gthomas/WorldsVeryFirst/juris/c-75/specimen.jpg

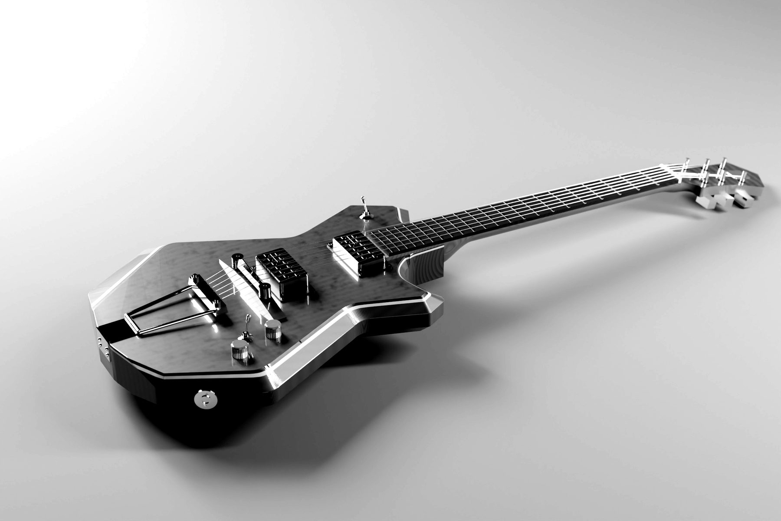
juris/c-75/specimen.jpg
