gthomas/WorldsVeryFirst/juris/c-75a/specimen.jpg

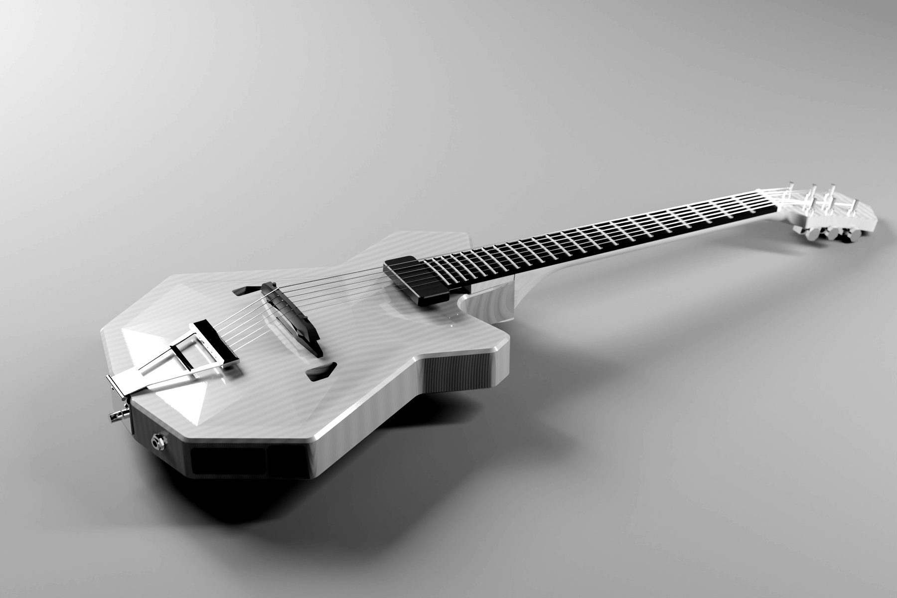
juris/c-75a/specimen.jpg
