gthomas/WorldsVeryFirst/juris-c75/files/juris_headstock_production.pdf

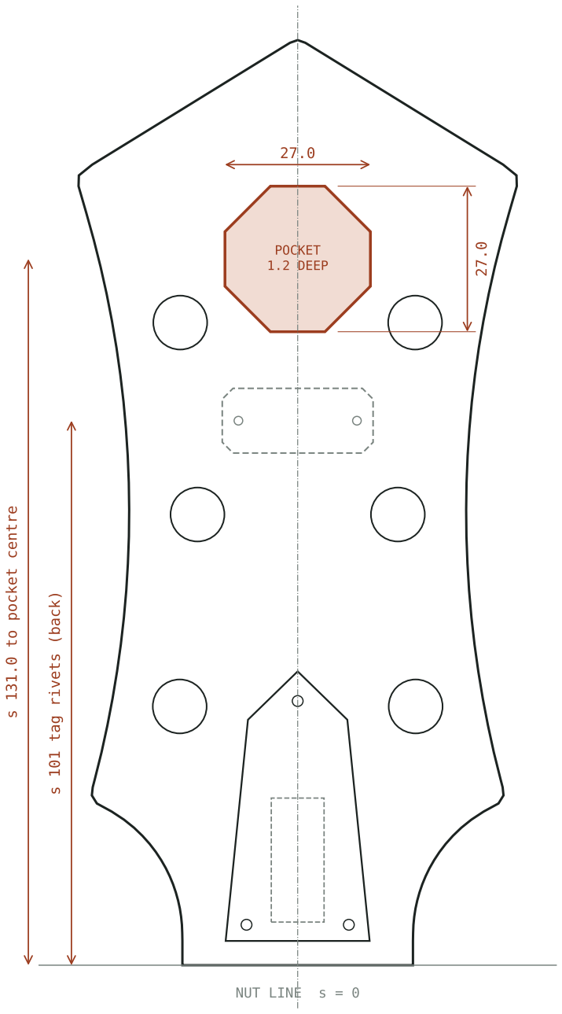
[picture p3: figure]
s 131.0 to pocket centre; s 101 tag rivets (back); NUT LINE; POCKET; DEEP

# JURIS PROFESSIONAL INSTRUMENTS

PRODUCTION HEADSTOCK | · | INSIGNIA POCKET | · | C-75 / C-75A / C-75T
1 | INSIGNIA POCKET: octagon 27.0 x 27.0, flats 10.13, centred on the centreline at s = 131.0.
| Depth 1.2 from the finished face (= plate thickness; plate sits flush). Flat floor.
| Corners are 135 deg: cut with a 1/16 in (1.6) end mill or smaller, or radius the plate corners to suit.
| Cut after the face veneer is glued and levelled; check depth against the actual plate before finishing.
2 | INSIGNIA PLATE (supplied): 1.2 nickel silver, etched, gutters filled black. Glue in after finish (epoxy).
3 | TRUSS ROD COVER: rosewood, JURIS engraved 0.3 deep and filled black, three screws, over the access slot.
4 | ASSET TAG (back of headstock): 28 x 12 plate, surface mounted after finish.
| Two rivet holes at x = +/-11, s = 101 (shown through), sized to the rivets supplied.
5 | CLEARANCE: pocket edge to the top tuner holes is 5.7 ; leaves about 3 mm to a 15 mm bushing washer.

Outline, tuner holes, slot and cover unchanged from Juris.dxf.

Not to scale as printed: work from juris_headstock_production.dxf. Solid: face. Dashed: truss slot under the cover.
Dotted: asset tag on the back, shown through.
