gthomas/WorldsVeryFirst/colonelhead.950aa0d0.jpg

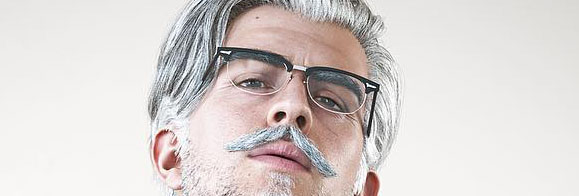
colonelhead.950aa0d0.jpg
