gthomas/WorldsVeryFirst/HARLAND.8d7c5698.gif

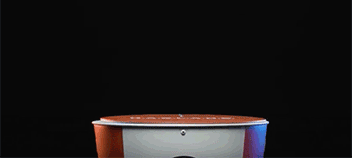
HARLAND.8d7c5698.gif
