gthomas/WorldsVeryFirst/juris-c75/prototype.jpg

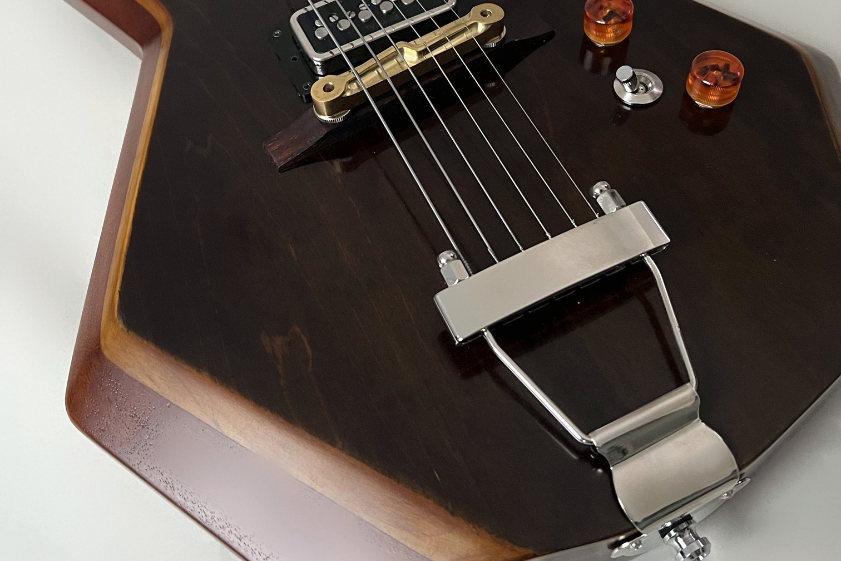
juris-c75/prototype.jpg
