gthomas/WorldsVeryFirst/juris/plan_juris-c75.png

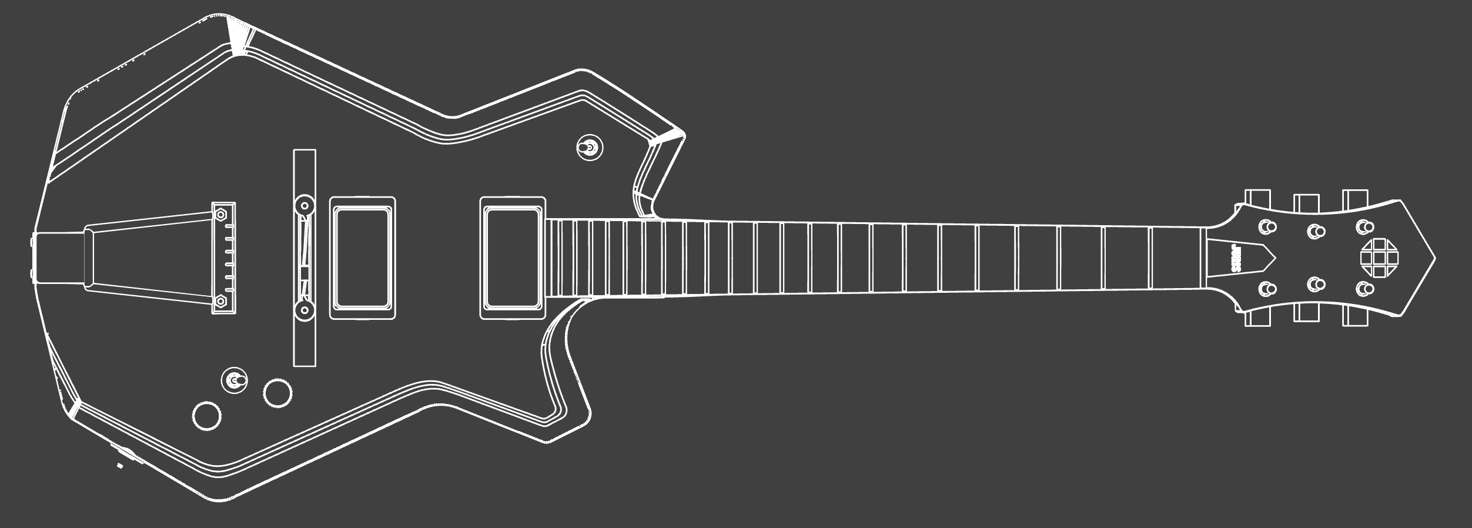
juris/plan_juris-c75.png
