gthomas/WorldsVeryFirst/juris/plan_juris-c75a.png

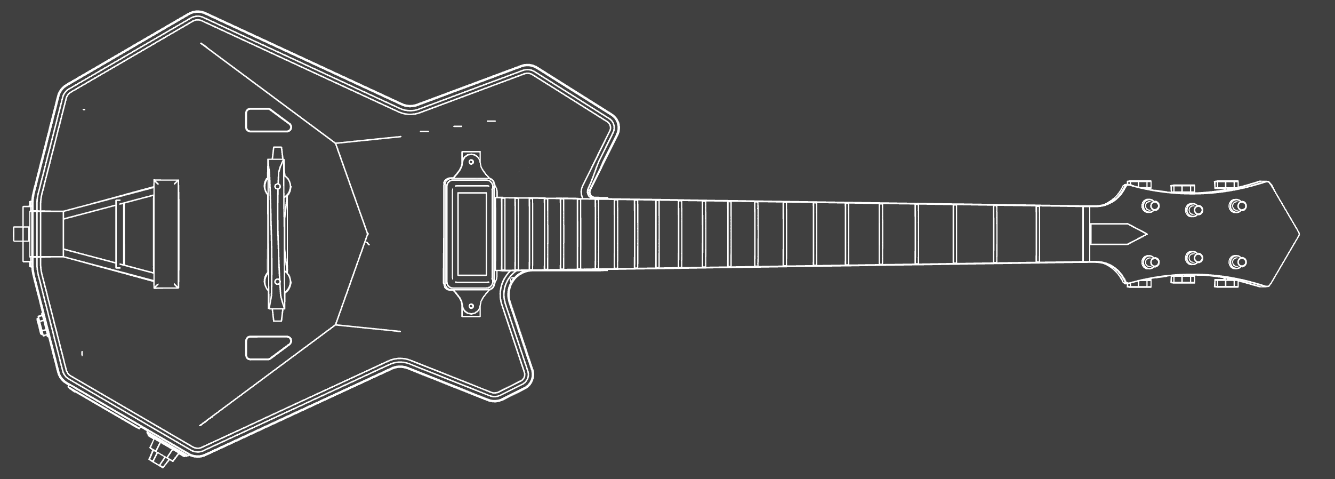
juris/plan_juris-c75a.png
