gthomas/WorldsVeryFirst/juris/plan_juris-c75t.png

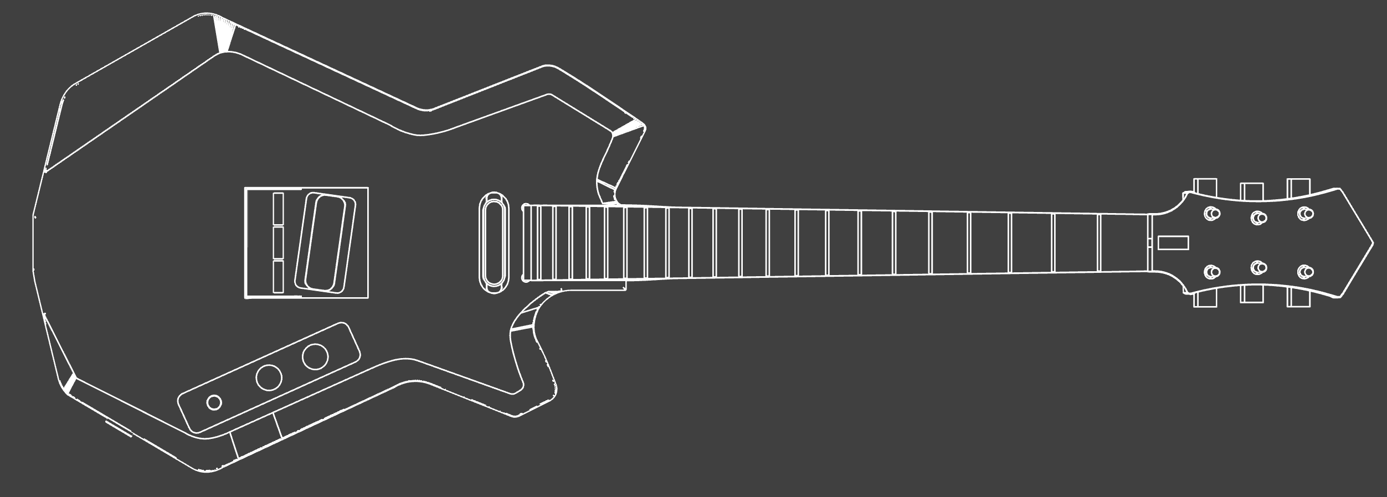
juris/plan_juris-c75t.png
