gthomas/WorldsVeryFirst/juris/share-c75.png

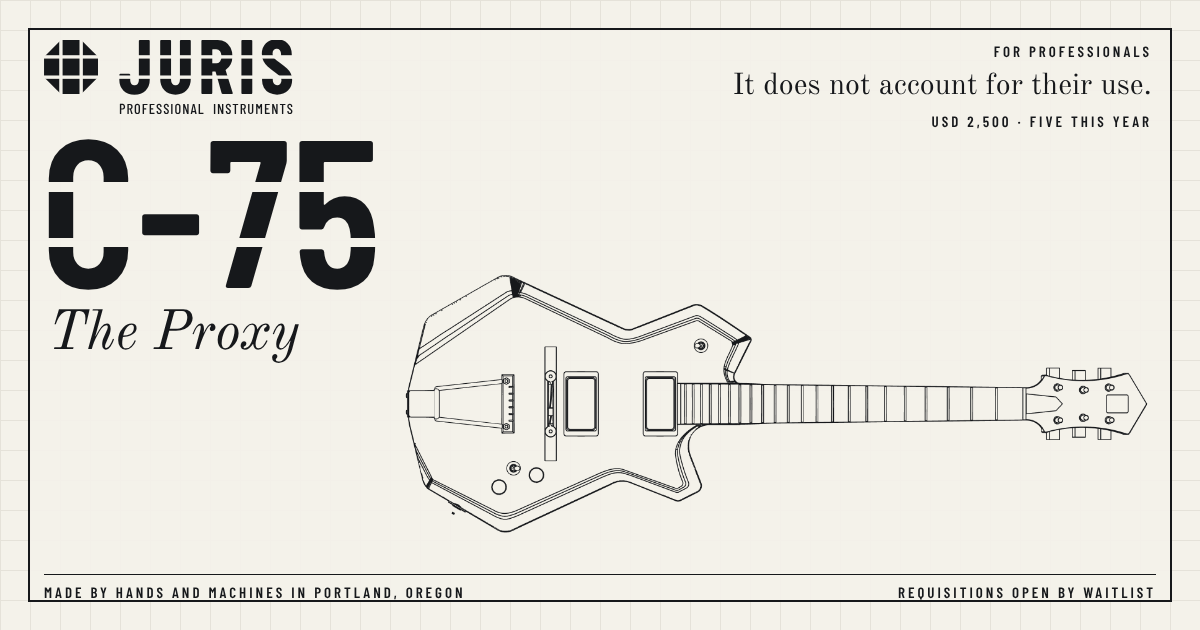
juris/share-c75.png
