gthomas/WorldsVeryFirst/lostinreddit.d3262f15.jpg

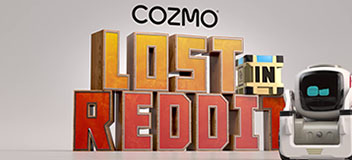
lostinreddit.d3262f15.jpg
