gthomas/WorldsVeryFirst/peeworldtrump.63bd835a.gif

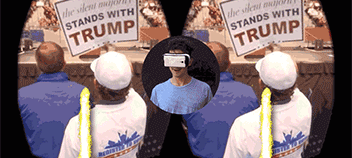
peeworldtrump.63bd835a.gif
