gthomas/WorldsVeryFirst/saturn.009b1ad3.jpg

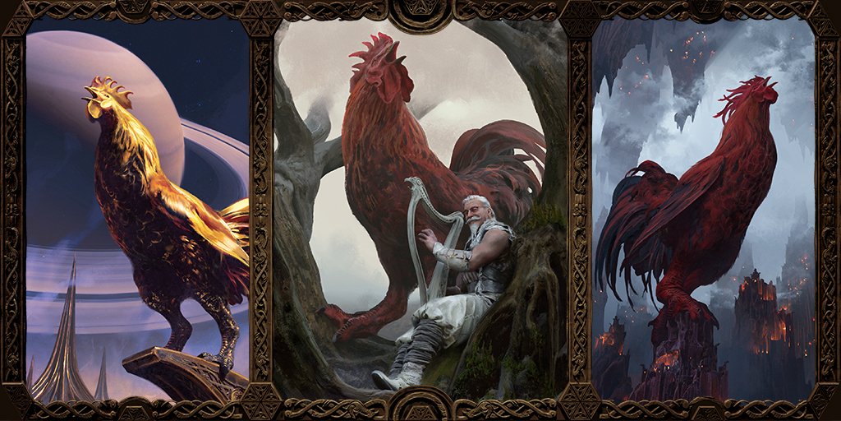
saturn.009b1ad3.jpg
