gthomas/WorldsVeryFirst/soy_route.58384286.png

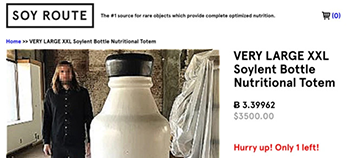
soy_route.58384286.png
