gthomas/WorldsVeryFirst/verizon_minecraft_videocall.c32c5149.gif

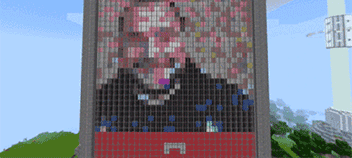
verizon_minecraft_videocall.c32c5149.gif
