gthomas/WorldsVeryFirst/juris-c75/files/headstock/truss_rod_cover.step

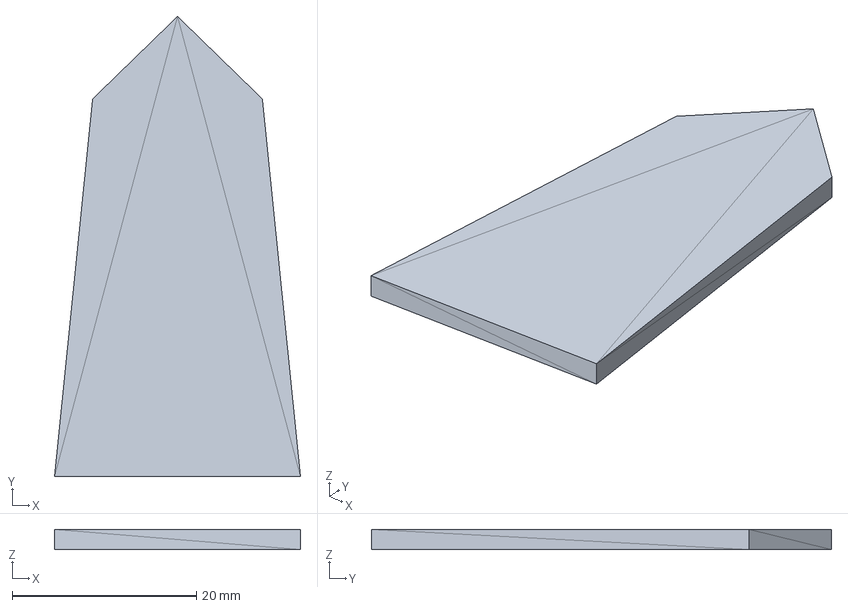
[picture p16: CAD file, 2026-11-13]
juris-c75/files/headstock/truss_rod_cover.step
26.7 x 50.0 x 2.20 mm
