gthomas/WorldsVeryFirst/juris-c75a/files/neck.stl

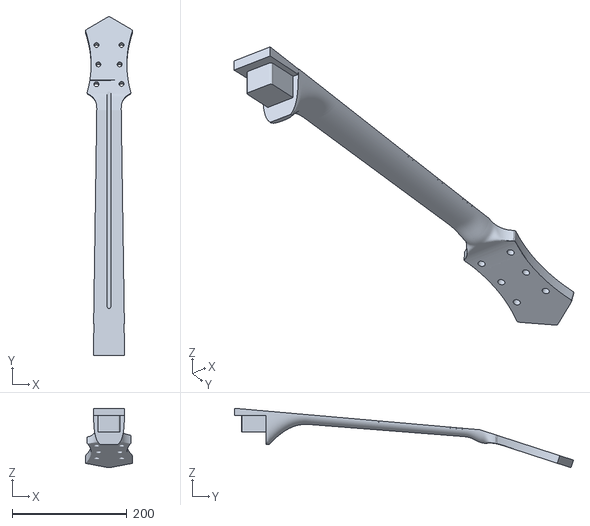
[picture p18: CAD file, 2026-11-13]
juris-c75a/files/neck.stl
81.4 x 591.9 x 103.8
