gthomas/WorldsVeryFirst/juris-c75t/files/body.stl

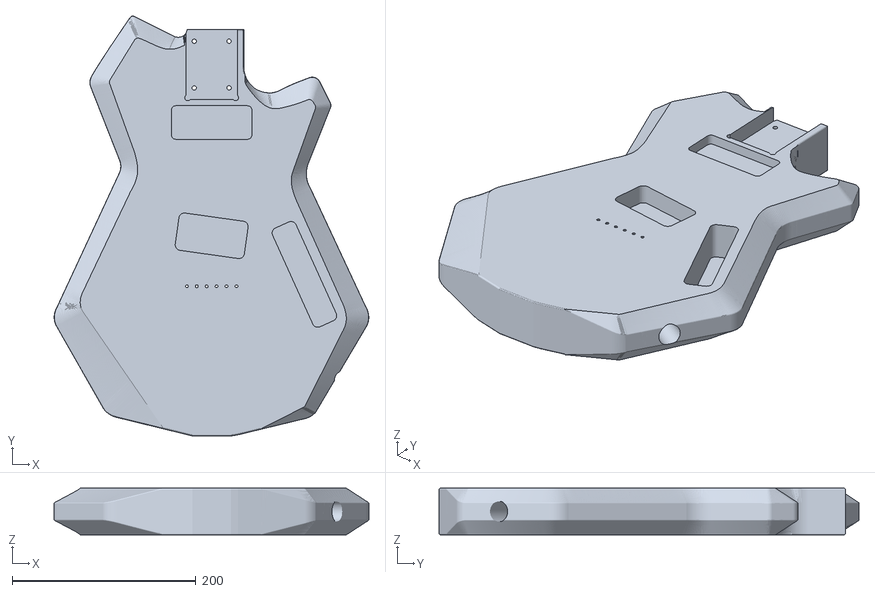
[picture p19: CAD file, 2026-11-13]
juris-c75t/files/body.stl
342.6 x 457.3 x 50.8
