gthomas/WorldsVeryFirst/juris-c75/files/headstock/asset_tag.step

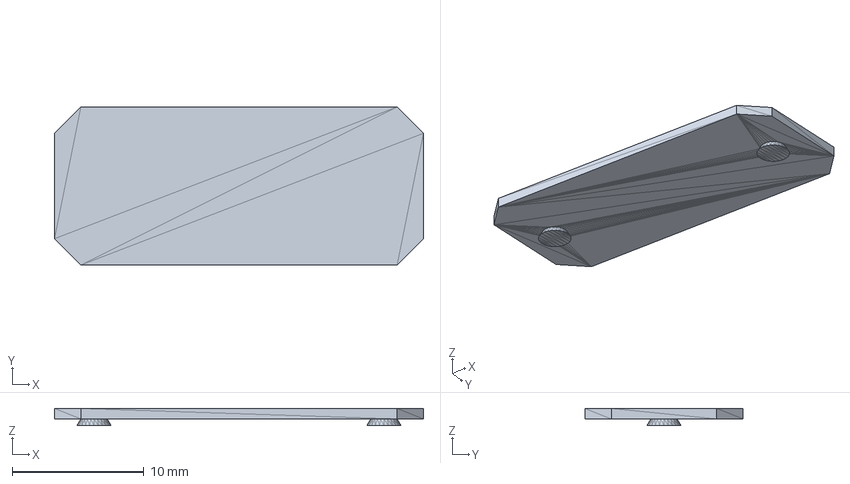
[picture p20: CAD file, 2026-11-13]
juris-c75/files/headstock/asset_tag.step
28.0 x 12.0 x 1.30 mm
