gthomas/WorldsVeryFirst/juris-c75a/files/juris_c75a_templates.dxf

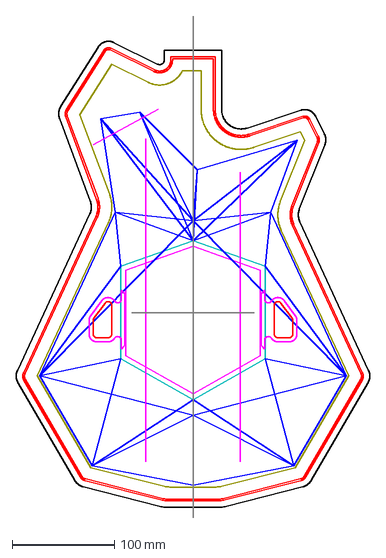
[picture p21: CAD file, 2026-11-01]
juris-c75a/files/juris_c75a_templates.dxf
345.5 x 490.0 mm
