gthomas/WorldsVeryFirst/juris-c75t/files/headstock_face_template.dxf

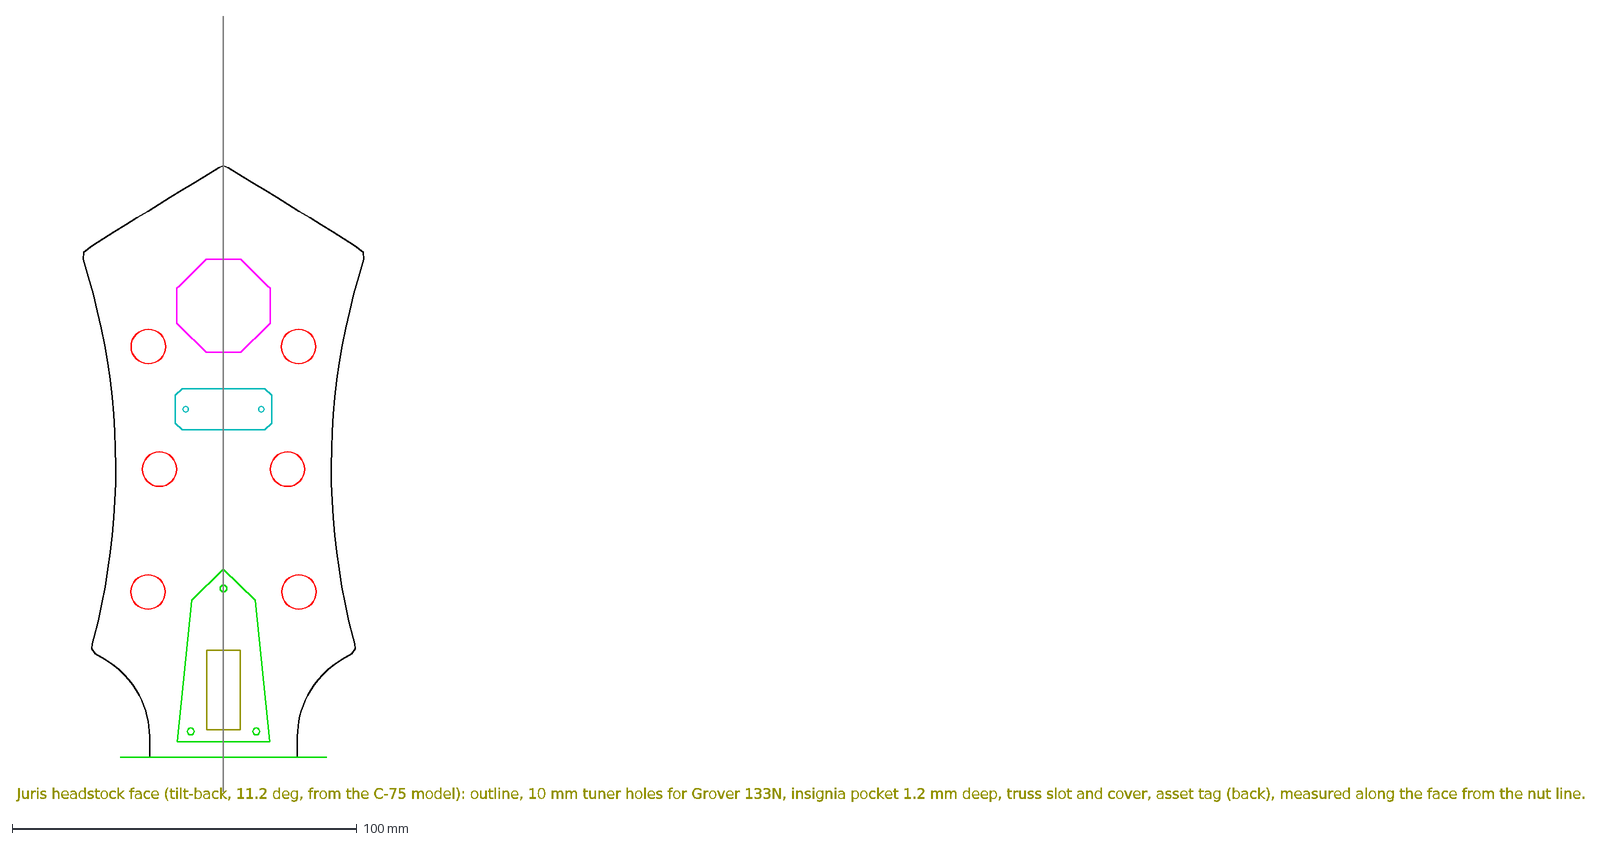
[picture p22: CAD file, 2026-11-13]
juris-c75t/files/headstock_face_template.dxf
Juris headstock face (tilt-back, 11.2 deg, from the C-75 model): outline, 10 mm tuner holes for Grover 133N, insignia pocket 1.2 mm deep, truss slot and cover,
