gthomas/WorldsVeryFirst/juris-c75/files/headstock/insignia_plate.step

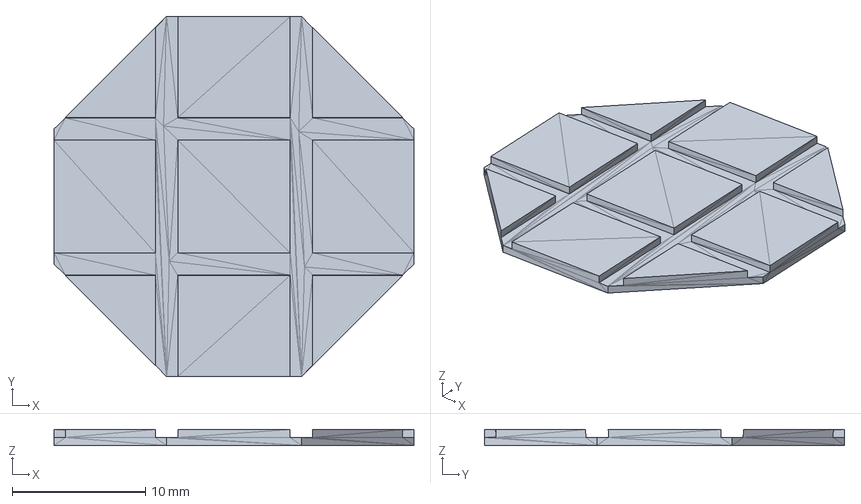
[picture p23: CAD file, 2026-11-13]
juris-c75/files/headstock/insignia_plate.step
27.0 x 27.0 x 1.20 mm
