gthomas/WorldsVeryFirst/juris-c75a/files/top.stl

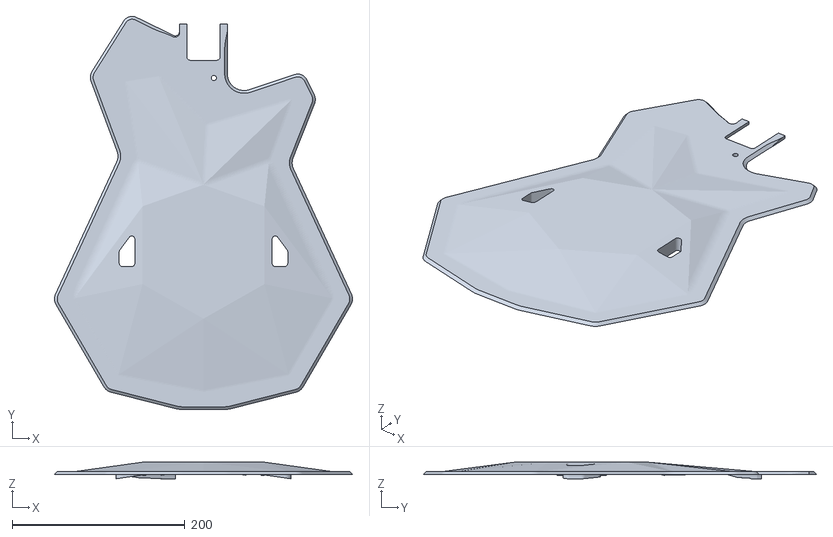
[picture p24: CAD file, 2026-11-01]
juris-c75a/files/top.stl
344.8 x 455.0 x 19.3
