gthomas/WorldsVeryFirst/juris-c75t/files/neck.stl

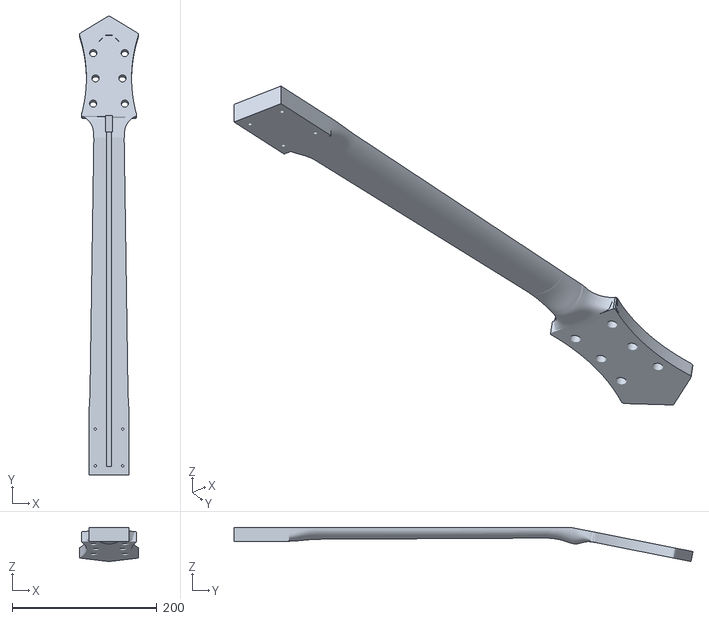
[picture p25: CAD file, 2026-11-13]
juris-c75t/files/neck.stl
81.4 x 635.2 x 47.1
