gthomas/WorldsVeryFirst/juris-c75a/files/rim.stl

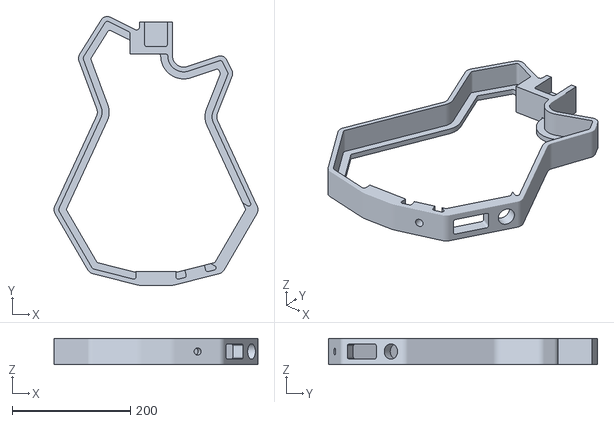
[picture p26: CAD file, 2026-11-01]
juris-c75a/files/rim.stl
345.5 x 455.6 x 44.5
