gthomas/WorldsVeryFirst/juris-c75t/files/headstock_template_paddle_neck.dxf

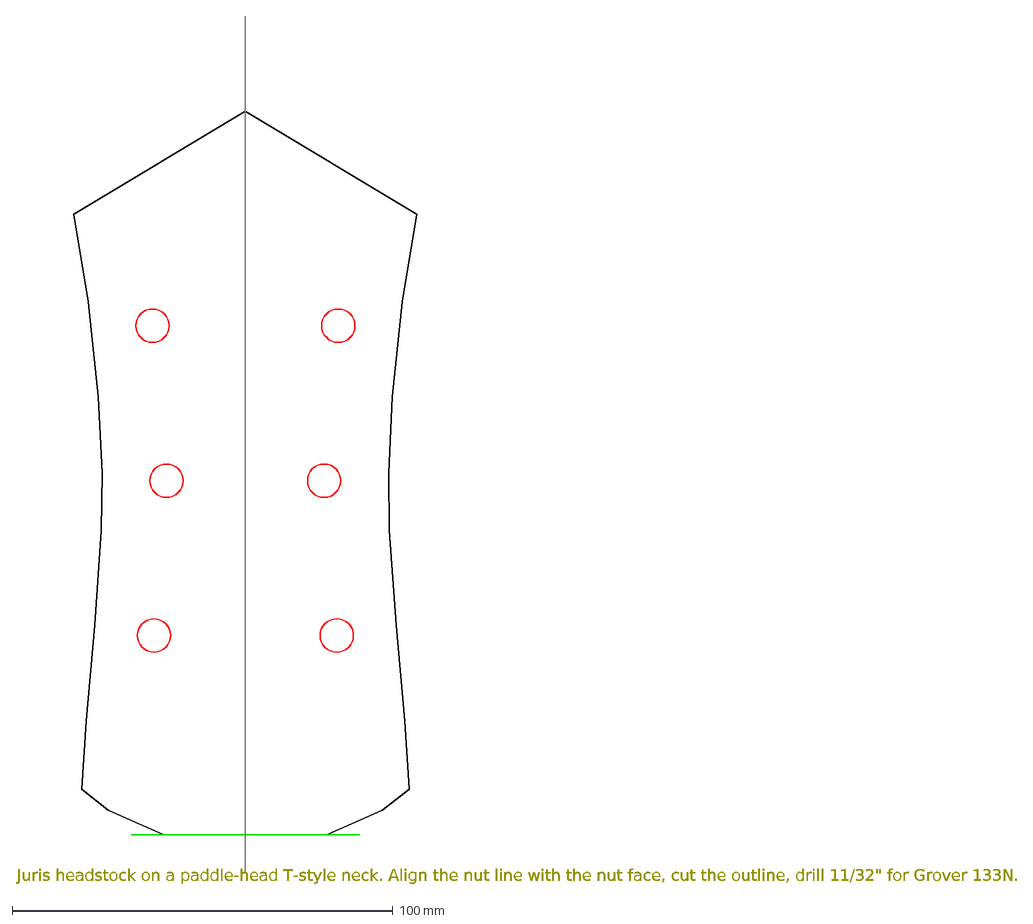
[picture p27: CAD file, 2026-10-31]
juris-c75t/files/headstock_template_paddle_neck.dxf
Juris headstock on a paddle-head T-style neck. Align the nut line with the nut face, cut the outline, drill 11/32" for Grover 133N.
