gthomas/WorldsVeryFirst/juris-c75a/files/bridge.stl

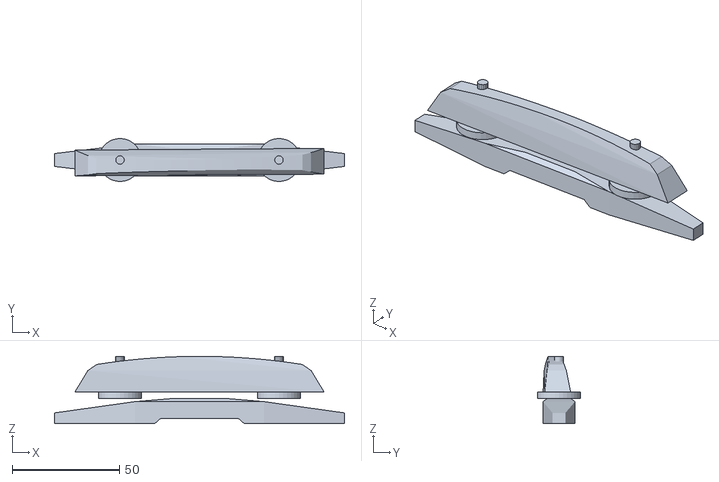
[picture p28: CAD file, 2026-11-01]
juris-c75a/files/bridge.stl
135.0 x 20.0 x 31.3
