gthomas/WorldsVeryFirst/juris-c75a/files/back.stl

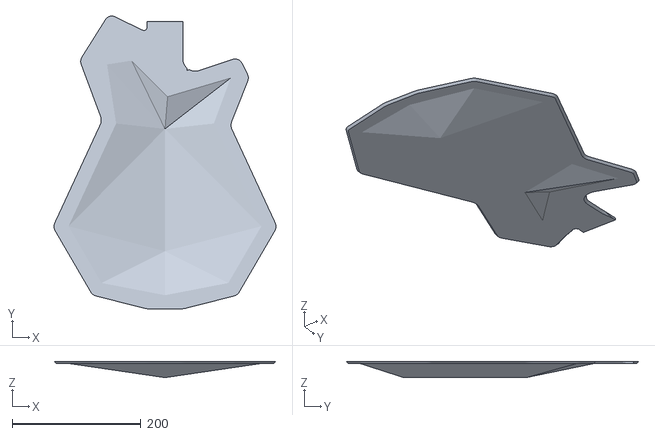
[picture p29: CAD file, 2026-11-01]
juris-c75a/files/back.stl
344.8 x 455.0 x 25.2
