gthomas/WorldsVeryFirst/juris-c75a/files/fingerboard.stl

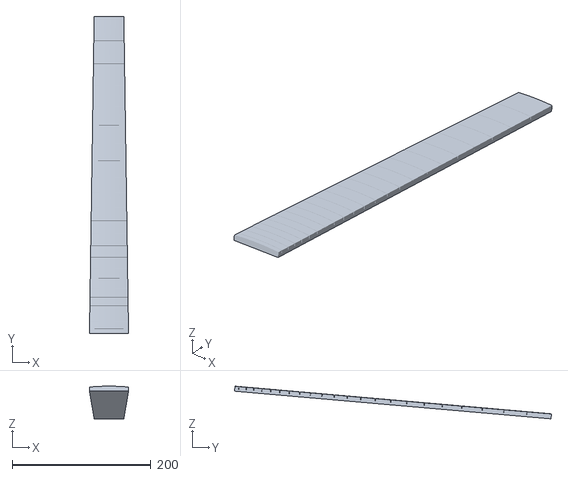
[picture p30: CAD file, 2026-11-01]
juris-c75a/files/fingerboard.stl
56.4 x 457.1 x 47.2
