gthomas/WorldsVeryFirst/(list of files, cad)

Other CAD files:
juris-c75/files/headstock/asset_tag.dxf
juris-c75/files/headstock/asset_tag.stl
juris-c75/files/headstock/insignia_plate.dxf
juris-c75/files/headstock/insignia_plate.stl
juris-c75/files/headstock/truss_rod_cover.dxf
juris-c75/files/headstock/truss_rod_cover.stl
