gthomas/WorldsVeryFirst/juris-c75t/files/BUILD_NOTES.md

# Juris C-75T "The Originalist" — build notes

A T-style solid body on the C-75 body as Chuck (WyreCustomGuitars) modelled it, with its bevelled edges, with a bolt-on 25.5" neck (tilt-back headstock, as on the C-75) and the classic T layout. Generated by `tstyle.py`; machining files by `cnc_t.py`.

## What's in the package

| File | What it is |
|---|---|
| `body/body.step`, `body/body.stl` | The body in machining position: XY centred, Z0 at the top surface. |
| `body/body_setup.dxf` | Stock outline, pin holes and origin, plus layers for the profile, bevel lines (top and back flats), neck pocket, both pickup routes, control cavity, bridge plate and control plate outlines, string-through holes and neck screws. |
| `neck/neck.step`, `neck/neck.stl`, `neck/neck_setup.dxf` | Custom bolt-on neck: X along the neck, Z0 at the fingerboard gluing plane. Setup A: gluing plane, truss rod channel, the 11.2° headstock face and the rod access slot. Setup B, flipped: back carve, volute, heel and headstock back. |
| `fingerboard/fingerboard.step`, `.stl`, `_setup.dxf` | 12" radius board, 21 fret slots, flat side down. |
| `headstock_face_template.dxf` | Headstock outline (from Chuck's C-75 model), 10 mm tuner holes, truss slot and cover, the insignia pocket (27 mm octagon, 1.2 mm deep, centred 131 mm up the face) and the asset tag on the back (shown through), measured along the angled face from the nut line. The neck STEP has the pocket cut. |
| `../model/juris_c75t.glb`, `report.json` | The full 3D model and its numbers. |

## Body

- **Stock:** swamp ash, alder or roasted pine, two-piece glued up to about 14¾ × 19¼ × 2⅛ in (8/4 rough), finished 2 in (50.8 mm), the same as the C-75.
- **Bevels:** Chuck's, from his C-75 model: flat facets that fall 5/8" (15.9 mm) from the flat of the top to the edge, and the same on the back, leaving a 3/4" square band round the side on this 2" body, as on the C-75. They are about 20 mm wide up the sides and widen to about 41 mm on the bass lower bout. The middle of the tail is left square, and the bevels narrow to nothing as they reach it. They run unbroken past the jack, as on the C-75. One change from the C-75: the treble side of the neck tongue and the cutaway are eased out 7.5 mm, so the standard 2.2" pocket keeps a wall on that side. The setup DXF has the top and back flat outlines.
- **Setup A, from the top:** bevel facets (1/4" ball-nose, fine stepover), then:
  - neck pocket
  - bridge pickup route
  - neck pickup route
  - control cavity
  - outside profile
- **Setup B, flipped about X on the pin line:** back bevel facets, then the six 8.2 mm ferrule counterbores, 6 mm deep.
- **Drilled through (vertical, so they can be done on the machine or a drill press):** the six 1/8" string holes and the four neck screw holes.
- **Drilled by hand after machining:**
  - wire channels: neck pickup to bridge pickup, bridge pickup to control cavity, control cavity to jack
  - the 7/8" jack bore, square to the side at the C-75's jack position, centred on the side band. No easing of the bevels: as on the C-75, the Electrosocket plate sits on the side band and lips over the bevel edges.
  - strap button holes
- **Undercut check (body):** clean. Every vertical line crosses the body surface at most twice.

## Neck pocket

Standard Fender pattern, 56.1 × 76.2 mm (2.2 × 3 in, plus 0.2 mm for fit), 15.9 mm (5/8") deep. A 1/4" cutter leaves round inside corners, so the pocket has small dog-bone reliefs at the two inner corners to let a square T-style heel seat fully. The neck meets the body at the 16th fret, which puts the saddle line 190 mm from the tail, the same spot as on the C-75A.

The four neck screw holes are drawn at a typical Fender spacing. **Check them against your neck plate and the neck's pilot holes before drilling.**

## Hardware to buy

| Item | Notes |
|---|---|
| Neck | **Made to the files, not bought:** stock T necks have flat headstocks. It's a maple blank about 26 × 3.75 × 2½ in, so the 11.2° headstock can be cut from one piece (or scarf-jointed). It has a standard Fender heel, 2.2 × 3 in, so the pocket stays standard. Board: 1/4 in ebony, 12 in radius. Add a 15 in dual-action truss rod, 1/4 × 3/8 in channel, adjusted at the headstock. Drill the tuner holes 11/32 in, square to the angled face, as a separate operation. The neck undercut check reads 2.5 mm², all where rays graze the angled headstock edges. |
| Tuners | Grover 133N, 3+3 (same as your other builds). |
| Headstock furniture | As on the C-75: nickel-silver insignia plate (27 mm octagon, 1.2 mm, gutters filled black) glued flush in its pocket; rosewood truss rod cover, JURIS engraved, three screws; asset tag riveted to the back of the headstock. |
| Bridge | Vintage 3-saddle T plate with string-through ferrules. The model uses about 82.5 × 92 mm with the back edge 25 mm behind the saddles. Lay your plate on the body before routing the bridge pickup. |
| Pickups | Bridge: standard vintage T bridge pickup on its brass baseplate, hanging from the bridge plate as usual. Neck: Lollar Gold Foil Soapbar (item 10-701-2, neck wind, about 6.2k), which fits a standard P-90 soapbar route: 86.4 × 35.4 mm, two screws through the cover (20 mm apart) into the route floor on springs. It sits about 10 mm proud of the top because of the bolt-on neck's height; Lollar's soapbar spacer ring is an option if you want the gap closed. |
| Controls | 5½ × 1¼ in T control plate, 3-way switch, 250k volume and tone pots, 0.047 µF tone cap (what Lollar recommends for the gold foil, and standard T values). |
| Jack | Electrosocket (round plate, two screws), as on the C-75 (7/8" bore) |
| Neck plate | Neck plate, four screws, and ferrules. The body is 1/4" thicker than a Telecaster, so use screws about 1/4" longer than stock (2" #8 instead of 1-3/4") |

## Check against your hardware before cutting

| Part | Assumed | Parameter in `tstyle.py` |
|---|---|---|
| Bridge pickup route | 76 × 41 mm, 19 mm deep, slanted 8° (fits a vintage T bridge pickup with its flatwork and baseplate) | `BRIDGE_PU` |
| Neck pickup route | 87.5 × 36.5 mm, 10 mm deep, 4.5 mm corner radius: a P-90 soapbar route for the Lollar Gold Foil Soapbar (86.4 × 35.4 mm, 16 mm tall), with 4 mm under it for the springs; 6.75 mm of wood to the neck pocket. Check against the pickup before cutting. | `NECK_PU` |
| Control cavity | 118 × 28 mm, 36 mm deep, under a 139.7 × 31.75 mm plate | `CTRL` |
| Bridge plate | 82.5 × 92 mm, string holes 20 mm behind the saddles, 2⅛" spacing | `BRIDGE`, `FERRULE_Y`, `string_spacing_bridge` |
| Neck heel | 2.2 × 3 in, 25.4 mm thick including the board | `pocket_w`, `pocket_L`, `heel_t` |
| Bevel | 5/8" drop at the edge, top and back (Chuck's model) | `chuck_geo.py`, `chuck_body.npz` |
