gthomas/WorldsVeryFirst/(commit log)

2026-10-30 Juris C-75A: machine-ready CNC package and updated model
    Two-piece rim, top-entry mortise, truss channel, fret slots, compensated bridge;
    STEP/STL per part, setup DXFs and machining guide.
    Claude-Session: https://claude.ai/code/session_01ENS5wyzEmKeJk69TCnZ1BL
2026-10-30 Juris C-75A: rim control plate, fingerboard-mounted pickup, no pickguard
    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
2026-10-30 Juris C-75A: EMG 91 on a fingerboard bracket, 9 V battery in the control cavity
    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
2026-10-30 Juris C-75A: concentric pot and battery door in the control plate
    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
2026-10-30 Juris C-75A: neck tongue under the fingerboard extension, neck set from above
    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
2026-10-30 Juris C-75A: finish selector, 141 mm plateau for the Gretsch base
    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
2026-10-30 Juris C-75A: 56 mm tail flat, soundhole lips for ~127 Hz air resonance, sun-yellowed white finish
    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
2026-10-30 Juris C-75A: lower the top arch to 11 mm for more acoustic output
    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
2026-10-30 Juris C-75A: broader 12 mm faceted back arch on the top's footprint
    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
2026-10-31 Juris C-75A: Richlite fingerboard, maple headstock face finished to match the top
    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
2026-10-31 Juris C-75A: optional Novak gold foil on a fingerboard-end bracket, pickup selector in the viewer
    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
2026-10-31 Juris pages: model switcher between the C-75A and C-75T
    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
2026-10-31 Juris C-75: model page for the original chambered guitar; three-way model switcher
    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
2026-10-31 Juris C-75T: drop the duplicate C-75A link from Files (the switcher covers it)
    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
2026-10-31 Juris C-75 and C-75T: headstock, tuner layout, truss slot, pickup routes and controls matched to the built guitar
    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
2026-10-31 Juris: built C-75 headstock on all three models, smooth head joints and heels, headstock faces follow the finish
    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
2026-10-31 Juris C-75T: tilt-back headstock with volute, custom neck and board machining files
    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
2026-10-31 Juris C-75: Gretsch-style tone switch, mahogany neck; C-75T: ebony board
    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
2026-11-01 Juris C-75 and C-75T fitted to Chuck's (WyreCustomGuitars) C-75 model: outline, 5/8in bevels with square tail, 0.2in cap, chambers, routes, control cavity, mortise, joint height, 11.2deg headstock, h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
2026-11-01 Juris C-75T: clean body STEP/STL after the lofted bevels; viewers rebuilt
    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
2026-11-01 Juris C-75 and C-75T: outline re-traced from Chuck's true edges only (rounded bass tail corner, no stray segment)
    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
2026-11-01 Juris C-75A The Amicus: rim from one standard 1-3/4in blank (one setup, no glue-up), 2.0in edge like the C-75; back arch 22 mm and 12 mm soundhole collars keep 5.2 L and ~127 Hz; Chuck's headstock
    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
2026-11-01 Juris C-75A The Amicus: stock electronics. Gotoh BB-04 battery box beside a small stacked-pot plate on the treble lower-bout face, Switchcraft 152B jack in the treble tail facet; router template for 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
2026-11-01 Juris C-75A: restore the model switcher
    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
2026-11-01 Juris C-75A The Amicus: Port Orford cedar top with a 25 mm radius inside every crease; FEA cedar vs spruce and a section check of the creases; lumber sources and cost in the machining guide
    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
2026-11-01 Juris C-75T and C-75: smooth the bevels where they fade out at the tail (Chuck's sampled edge heights wobbled), a proper flat for the T's cup jack, cleaner display roundover
    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
2026-11-02 Juris C-75A The Amicus: specify Dunlop 6105 fret wire
    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
2026-11-02 Juris C-75A The Amicus: write down the nut width (1-11/16 in, as on the C-75) and nut blank
    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
2026-11-03 Juris viewers: draw on demand instead of every frame, shadow map only updated on changes, lighter settings on Safari, reload if the WebGL context is lost (models were vanishing in desktop Safari)
    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
2026-11-04 Juris C-75A The Amicus: path-traced hero render at the top of the page
    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
2026-11-04 Juris C-75 The Proxy and C-75T The Originalist: path-traced hero renders at the top of their pages
    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
2026-11-06 Add Juris drawing register (/juris/) and C-75 case file (/juris/c-75/)
    The register is the brand home: common outline of the C-75, C-75A and
    C-75T on shared datums, the register of instruments, notices and the
    requisition form. The case file presents the C-75 as a six-sheet patent
    drawing set with the live model drawn as patent figures. Existing
    juris-c75, juris-c75a and juris-c75t pages are unchanged.
    Claude-Session: https://claude.ai/code/session_01ENS5x2HUAQg49NhbWzV77B
2026-11-06 Add C-75A and C-75T case files; link them from the register
    Both follow the C-75 case file: six patent drawing sheets with the live
    model drawn in patent mode, a FIG. 1-8 index, reference numerals, claims,
    conditions of use, manufacture (with the existing machining packages
    linked as issued documents), prior art and allocation. FIG. 0 on each is
    a rendering, labelled as such, since no unit has been produced.
    The register and the C-75 case file now link to /juris/c-75a/ and
    /juris/c-75t/. The original juris-c75a and juris-c75t pages are unchanged.
    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
2026-11-06 Juris case files: bill of materials, tighter copy, nickel silver frets
    Each case file cover now carries a bill of materials keyed to the
    reference numerals, so the instrument's specification reads plainly.
    Claims, notes, defined terms, conditions, procedures and inspection
    records are shortened; brand and part names move from the claims to
    the bill of materials, and prior-art references point to items.
    Frets are nickel silver on every model, in the copy and in the C-75
    renders. The register now reads 'for professionals'.
    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
2026-11-06 Juris: adopt T1 insignia (nine-patch section) across register and case files; Notice 006
    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
2026-11-07 C-75: Graph Tech nut
    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
2026-11-07 Juris: builder of record (case files, C-75 builder's plate, Notice 007)
    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
2026-11-07 C-75 case file: complete specification (neck depths, headstock, controls, jack, tuners, asset tag, finish, colours, setup, case, lead time)
    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
2026-11-07 C-75: production pickups are English-mount T-Armonds
    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
2026-11-07 C-75: English-mount T-Armonds in the model, drawings and build page; prototype pickups noted
    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
2026-11-08 Juris register drawings: trapeze wire drawn in full (tailpiece in a top pass); share card refreshed
    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
2026-11-09 Juris: motto lock-up at the close of case files (L5), register colophon and Exhibit A (L1), and the requisition receipt
    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
2026-11-09 C-75 production headstock: nine-patch nickel-silver inlay (55) and engraved truss-rod cover (54) in model, parts list and register plan
    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
2026-11-09 C-75 badge: one etched nickel-silver plate, gutters filled black
    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
2026-11-09 C-75 model: asset tag (56) as a riveted plate on the back of the headstock
    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
2026-11-09 C-75 controls: volume per pickup, tone by three-way switch (open, .0039, .012 uF)
    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
2026-11-09 C-75 fingerboard: no face markers, side dots only
    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
2026-11-09 C-75: chamber is reference (21), body keeps (20)
    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
2026-11-10 Juris C-75 build page: prototype photograph replaces the earlier-finish render
    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
2026-11-10 Juris C-75 build page: smoothed prototype photograph
    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
2026-11-10 Juris C-75 build page: prototype photograph, paper tint evened
    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
2026-11-13 Juris headstock: C-75 production headstock on all three models
    The Amicus and the Originalist now carry the same headstock furniture as the
    C-75: the nickel-silver insignia set flush in an octagonal pocket, a rosewood
    truss rod cover engraved JURIS, and an asset tag riveted to the back. All
    three build it from one shared module (insignia.py).
    Machining files carry the pocket: the Amicus faceplate DXF and the
    Originalist headstock template have it on their own layer, and the
    Originalist neck STEP has it cut. The C-75 files add fabrication drawings
    for the insignia plate, truss rod cover and asset tag (DXF, STEP, STL) and a
    dimensioned headstock drawing.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
2026-11-13 Juris C-75T: Lollar Gold Foil Soapbar in the neck position
    The neck pickup is now a Lollar Gold Foil Soapbar in a P-90 soapbar route
    (87.5 x 36.5 mm, 10 mm deep), mounted with two screws on springs. It
    replaces the chrome T neck pickup. The page adds a Neck pickup view, and
    the build notes, CNC setup DXF and hero render are updated.
    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
